esden/fx2grok/hardware/fx2grok-flat/0.3/fx2grok-flat.kicad_pcb

## KiCad design hardware/fx2grok-flat/0.3/fx2grok-flat.kicad_pcb (2018-04-19)

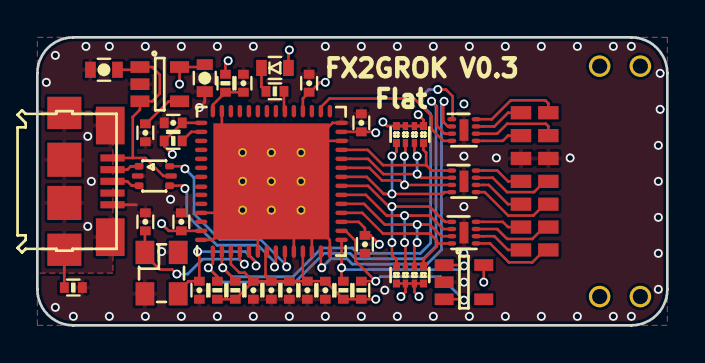
[picture p1: board hardware/fx2grok-flat/0.3/fx2grok-flat.kicad_pcb from above]

Board: 4 copper layers, 35.0 x 16.0 mm, 37 parts (0 on the bottom side), 41 nets.

Parts:
C1, C2, C3, C4, C5, C6, C9, C10: 100n; C_0402
C7, C8: 2u2; C_0402
C11, C13: 4u7; C_0603
C12: 10n; C_0402
C14: 1u; C_0402
C15, C16: 10p; C_0402
D1: GRN; D_0603
IC1: CY7C68013A-56; QFN-56-1EP_8x8mm_Pitch0.5mm
J1: Conn; TFM-107-02-x-DH
P1: pkl_USB_OTG; Connector_USB_Micro_B_SMD
R1, R2, R3, R4: 2k7; R_0402
R5, R6, R7: 100k; R_0402
R8, R9: 100k; R_Array_Convex_4x0402
R10: 1m; R_0402
U1: 3.3V; SOT-23-5
U2: USBLC6-2; SOT-666
U3, U4, U6: IP425x-4-TTL; DFN-8-1EP_1.35x1.7mm_Pitch0.4mm
U5: 24LC00; SOT-23-5
X1: 24MHz; ABM8

Connections:
+3V3: C1.1, C2.1, C3.1, C4.1, C5.1, C6.1, C7.1, C8.1, C9.1, C10.1, C13.1, D1.A, IC1.3, IC1.7, IC1.11, IC1.17, IC1.27, IC1.32, IC1.43, IC1.55, R2.2, R3.2, R4.2, R5.2, R6.1, R7.1, R8.2, R8.4, R8.6, R8.8, R9.2, R9.4, R9.6, R9.8, U1.5, U5.5
+5V: C11.1, P1.1, U1.1, U1.3, U2.5
/CLK: IC1.30, U6.4
/IFCLK: IC1.13, U6.2
/PA1: IC1.34, R1.2
/PB0: IC1.18, R8.1, U3.4
/PB1: IC1.19, R8.3, U3.3
/PB2: IC1.20, R8.5, U3.2
/PB3: IC1.21, R8.7, U3.1
/PB4: IC1.22, R9.1, U4.4
/PB5: IC1.23, R9.3, U4.3
/PB6: IC1.24, R9.5, U4.2
/PB7: IC1.25, R9.7, U4.1
/SCL: IC1.15, R2.1, U5.1
/SDA: IC1.16, R3.1, U5.3
/TRIG: IC1.1, R6.2, U6.3
/TRIG2: IC1.2, R7.2, U6.1
/USBD_N: IC1.9, U2.6
/USBD_P: IC1.8, U2.4
/WAKEUP: IC1.44, R5.1
/XTALIN: C16.1, IC1.5, X1.2
/XTALOUT: C15.1, IC1.4, X1.1
/shield: P1.GND, R10.1
/xCLK: J1.12, U6.5
/xIFCLK: J1.14, U6.7
/xPB0: J1.1, U3.5
/xPB1: J1.2, U3.6
/xPB2: J1.3, U3.7
/xPB3: J1.4, U3.8
/xPB4: J1.5, U4.5
/xPB5: J1.6, U4.6
/xPB6: J1.7, U4.7
/xPB7: J1.8, U4.8
/xTRIG: J1.11, U6.6
/xTRIG2: J1.13, U6.8
/xUSBD_N: P1.2, U2.1
/xUSBD_P: P1.3, U2.3
/~RESET: C14.1, IC1.42, R4.1
GND: C1.2, C2.2, C3.2, C4.2, C5.2, C6.2, C7.2, C8.2, C9.2, C10.2, C11.2, C12.2, C13.2, C14.2, C15.2, C16.2, IC1.6, IC1.10, IC1.12, IC1.14, IC1.26, IC1.28, IC1.41, IC1.53, IC1.56, IC1.57, J1.9, J1.10, P1.5, R10.2, U1.2, U2.2, U3.9, U4.9, U5.2, U6.9, X1.GND
unnamed: C12.1, U1.4
unnamed: D1.C, R1.1
