esden/fx2grok/hardware/fx2grok-flat/0.1/fx2grok-flat.kicad_pcb

## KiCad design hardware/fx2grok-flat/0.1/fx2grok-flat.kicad_pcb (2018-04-13, an earlier design)

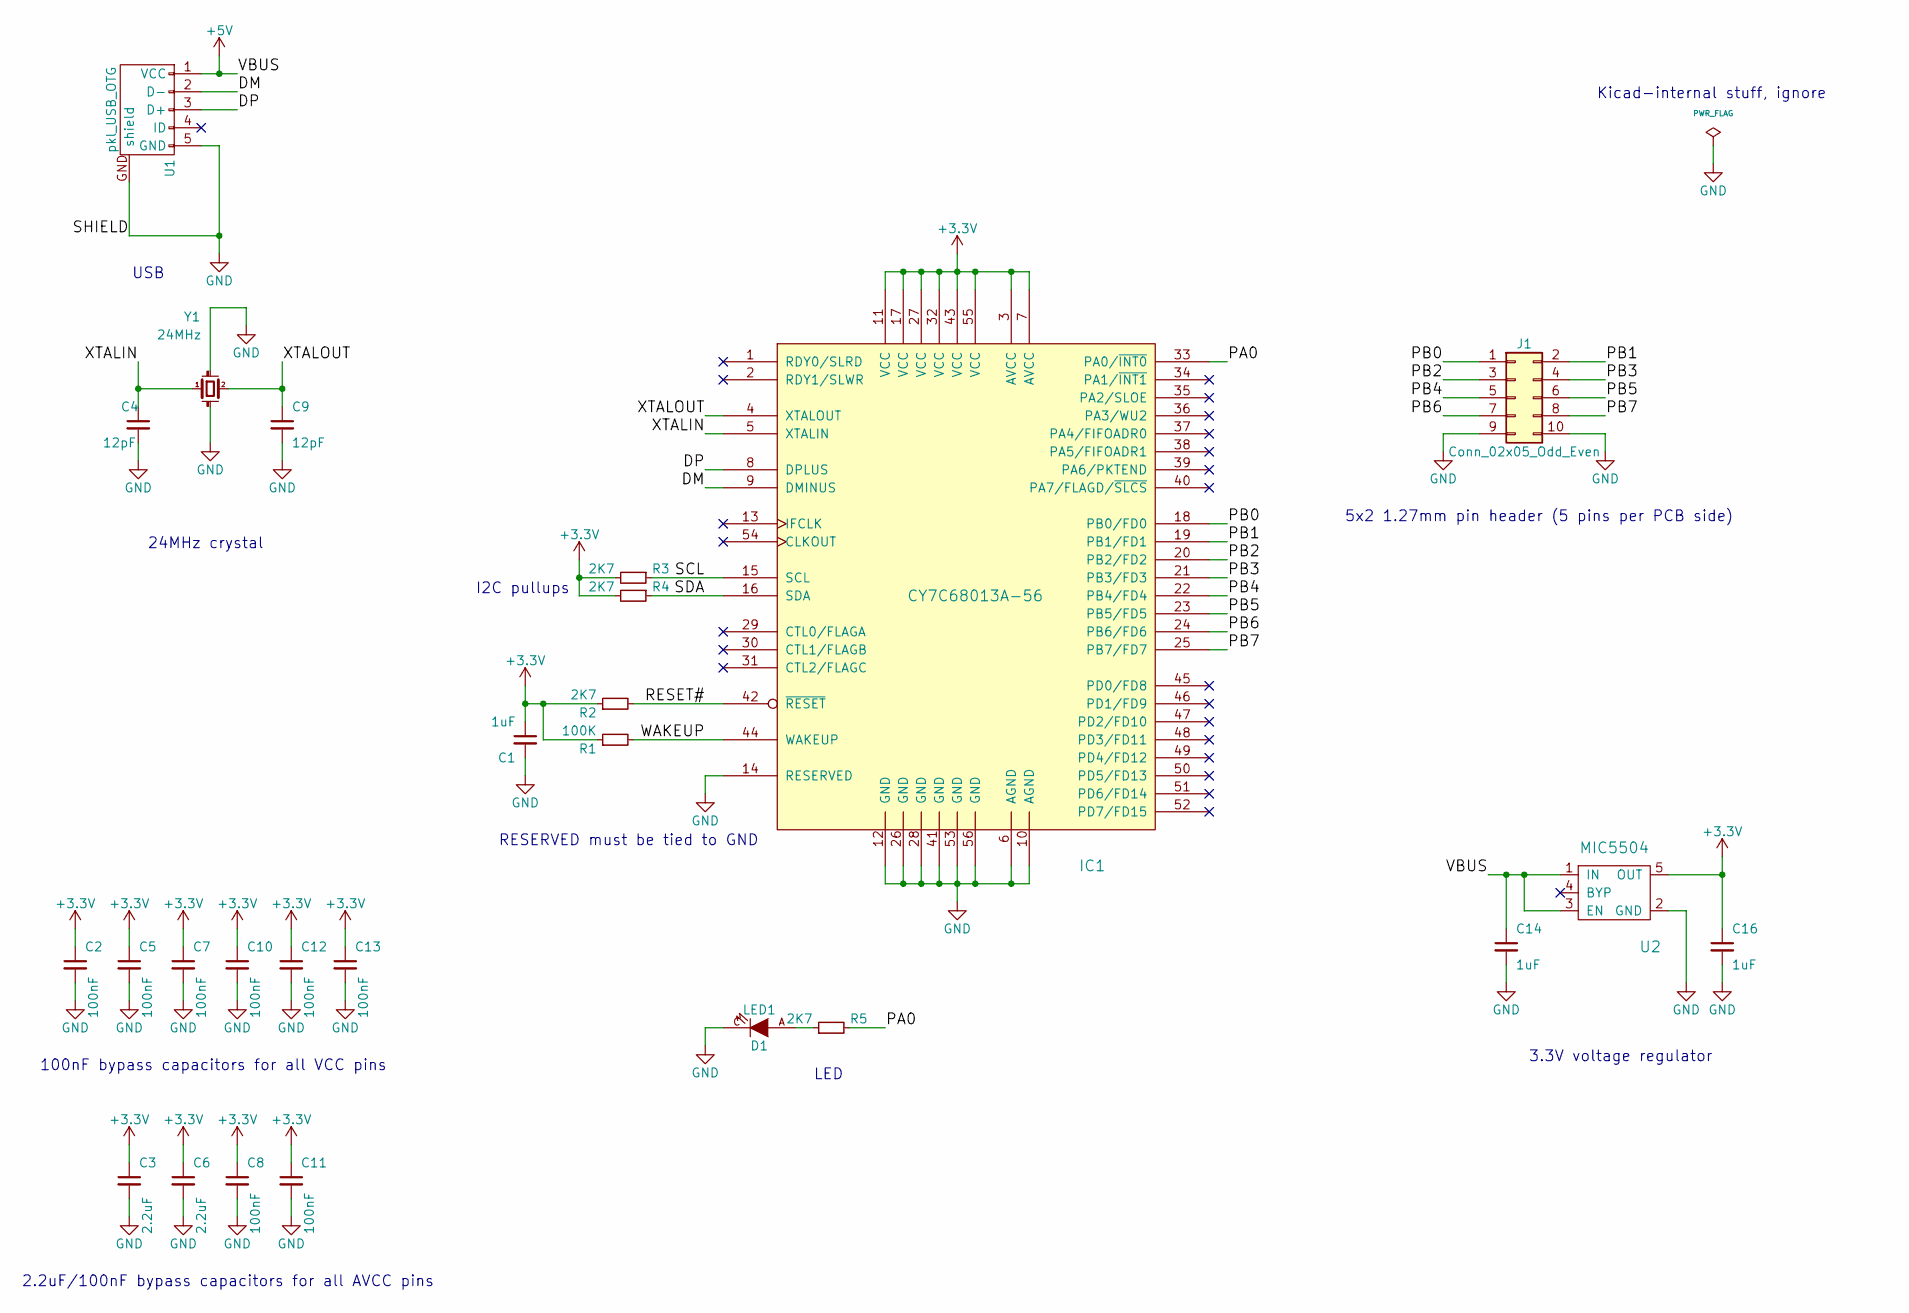
[picture p2: schematic fx2grok-flat.sch]

Parts:
C1, C14, C16: 1uF; C_0402
C2, C5, C7, C8, C10, C11, C12, C13: 100nF; C_0402
C3, C6: 2.2uF; C_0402
C4, C9: 12pF; C_0402
D1: LED1; D_0603
IC1: CY7C68013A-56; QFN-56-1EP_8x8mm_Pitch0.5mm
J1: Conn_02x05_Odd_Even; FTSH-105-XX-X-DV
R1: 100K; R_0402
R2, R3, R4, R5: 2K7; R_0402
U1: pkl_USB_OTG; Connector_USB_Micro_B_SMD
U2: MIC5504; SOT-23-5
Y1: 24MHz; ABM8

Connections:
+3V3: C1.1, C2.1, C3.1, C5.1, C6.1, C7.1, C8.1, C10.1, C11.1, C12.1, C13.1, C16.1, IC1.3 (AVCC), IC1.7 (AVCC), IC1.11 (VCC), IC1.17 (VCC), IC1.27 (VCC), IC1.32 (VCC), IC1.43 (VCC), IC1.55 (VCC), R1.1, R2.1, R3.2, R4.2, U2.5 (OUT)
+5V: C14.1, U1.1 (VCC), U2.1 (IN), U2.3 (EN)
/DM: IC1.9 (DMINUS), U1.2 (D-)
/DP: IC1.8 (DPLUS), U1.3 (D+)
/PA0: IC1.33 (PA0/~INT0), R5.2
/PB0: IC1.18 (PB0/FD0), J1.1
/PB1: IC1.19 (PB1/FD1), J1.2
/PB2: IC1.20 (PB2/FD2), J1.3
/PB3: IC1.21 (PB3/FD3), J1.4
/PB4: IC1.22 (PB4/FD4), J1.5
/PB5: IC1.23 (PB5/FD5), J1.6
/PB6: IC1.24 (PB6/FD6), J1.7
/PB7: IC1.25 (PB7/FD7), J1.8
/RESET#: IC1.42 (~RESET), R2.2
/SCL: IC1.15 (SCL), R3.1
/SDA: IC1.16 (SDA), R4.1
/WAKEUP: IC1.44 (WAKEUP), R1.2
/XTALIN: C4.1, IC1.5 (XTALIN), Y1.1
/XTALOUT: C9.1, IC1.4 (XTALOUT), Y1.2
GND: C1.2, C2.2, C3.2, C4.2, C5.2, C6.2, C7.2, C8.2, C9.2, C10.2, C11.2, C12.2, C13.2, C14.2, C16.2, D1.C, IC1.6 (AGND), IC1.10 (AGND), IC1.12 (GND), IC1.14 (RESERVED), IC1.26 (GND), IC1.28 (GND), IC1.41 (GND), IC1.53 (GND), IC1.56 (GND), J1.9, J1.10, U1.5 (GND), U1.GND (shield), U2.2 (GND), Y1.GND (case)
unnamed: D1.A, R5.1

Notes on the sheet:
5x2 1.27mm pin header (5 pins per PCB side)
Kicad-internal stuff, ignore
LED
24MHz crystal
3.3V voltage regulator
USB
RESERVED must be tied to GND
2.2uF/100nF bypass capacitors for all AVCC pins
100nF bypass capacitors for all VCC pins
I2C pullups

Board: 4 copper layers, 26 parts (0 on the bottom side), 21 nets, no tracks yet.
