esden/fx2grok/(commit log)

2017-09-23 fx2grok-tiny: Move all files into 0.1/ again after all.
    [fx2grok-tiny-B.Cu.gbl, fx2grok-tiny-B.Mask.gbs, fx2grok-tiny-B.Paste.gbp, fx2grok-tiny-Edge.Cuts.gm1, fx2grok-tiny-F.Cu.gtl, fx2grok-tiny-F.Mask.gts, fx2grok-tiny-F.Paste.gtp, fx2grok-tiny-drl_map.gbr]
2017-09-23 fx2grok-tiny: Add missing Y1 to silkscreen.
    [fx2grok-tiny.kicad_pcb]
2017-09-23 fx2grok-tiny: Add a silkscreen circle for the FX2's pin 1.
    [fx2grok-tiny.kicad_pcb]
2017-09-23 fx2grok-tiny: Place "values" on silkscreen but hide by default.
    These can be enabled when needed to have a nice assembly helper
    view in the Kicad 3D viewer.
    [fx2grok-tiny.kicad_pcb]
2017-09-23 fx2grok-tiny: Add warnings that version 0.1 is broken.
    [fx2grok-tiny.kicad_pcb, fx2grok-tiny.sch]
2017-09-29 fx2grok-tiny: Add initial 0.2 version.
    Almost identical to 0.1, only the metadata has been updated
    and the 0.1 being broken warnings are removed.
    [fx2grok-tiny.kicad_pcb, fx2grok-tiny.sch]
2017-09-29 fx2grok-tiny: Fix incorrect FX2 footprint.
    [fx2grok-tiny.kicad_pcb]
2017-09-29 fx2grok-tiny: Reroute PCB from scratch with various changes.
    - The previously incorrect FX2 footprint is fixed now.
    - The FX2's thermal pad is set to GND now.
    - The FX2 footprint now has a dot on the copper as well as on the
    silkscreen for pin 1.
    - The PCB is now 11x11mm (instead of 13x13mm).
    - The 1.27mm pin header connectors are shortened and the pinout changed.
    - The trace clearance changed from 6mil to 5mil.
    - The USB connector footprint now has two oval pads (space reasons).
    - The LED is now connected to PA1 (not PA0).
    - The schematics/layout license is changed to CC-BY-SA 4.0.
    [fx2grok-tiny.kicad_pcb, fx2grok-tiny.sch]
2017-09-29 fx2grok-tiny: Add generated 0.2 Gerber files.
    [fx2grok-tiny-B.Cu.gbl, fx2grok-tiny-B.Mask.gbs, fx2grok-tiny-B.Paste.gbp, fx2grok-tiny-Edge.Cuts.gm1, fx2grok-tiny-F.Cu.gtl, fx2grok-tiny-F.Mask.gts, fx2grok-tiny-F.Paste.gtp, fx2grok-tiny.drl]
2017-12-16 fx2grok-tiny: Random cosmetic/silkscreen changes.
    These are mostly done for being able to generate nice 3D previews in
    KiCad that can be helpful for assembling the device.
    [fx2grok-tiny.kicad_pcb]
2018-04-13 Added gitignore for kicad backup and net files.
2018-04-13 Added pretty-kicad-libs library submodule.
2018-04-13 Initial commit of fx2grok-flat.
    [fx2grok-flat.kicad_pcb, fx2grok-flat.sch]
2018-04-13 Recreated original schematic + input protection.
    [fx2grok-flat.kicad_pcb, fx2grok-flat.sch]
2018-04-13 Added eeprom and pullups on probe inputs. Started routing.
    [fx2grok-flat.kicad_pcb, fx2grok-flat.sch]
2018-04-13 FX2Grok-flat with new frontend first routing pass.
    This is the status of the design as included on esden KiCad LP.
    [fx2grok-flat.kicad_pcb, fx2grok-flat.sch]
2018-04-13 Cleaned up and grouped schematic sections.
    [fx2grok-flat.sch]
2018-04-13 More cleanup of the board routing.
    [fx2grok-flat.kicad_pcb, fx2grok-flat.sch]
2018-04-13 Final cleanup before placing prototype order.
    [fx2grok-flat.kicad_pcb]
2018-04-13 Placement plan layout.
    [fx2grok-flat.kicad_pcb]
2018-04-13 Added BOM unique part keys and made a few minor adjustments.
    [fx2grok-flat.sch]
2018-04-13 Minor value adjustment.
    [fx2grok-flat.kicad_pcb, fx2grok-flat.sch]
2018-04-14 Initial commit of fx2grok-flat V0.3.
    [fx2grok-flat.kicad_pcb, fx2grok-flat.sch]
2018-04-14 Added 3d models to the board file.
    [fx2grok-flat.kicad_pcb]
2018-04-19 Moved config flash to clean up PB0 trace.
    [fx2grok-flat.kicad_pcb]
2018-04-19 Untangled the TRIG and IFCLK traces.
    [fx2grok-flat.kicad_pcb]
2018-04-19 Added TRIG2 (RDY1/SLWR) as per @StefanBruens request. :D
    [fx2grok-flat.kicad_pcb, fx2grok-flat.sch]
2018-04-19 Added via stitching around the board.
    [fx2grok-flat.kicad_pcb]
2018-04-19 Corrected board length. (was off by 0.1mm)
    [fx2grok-flat.kicad_pcb]
2018-04-19 Updated USB ESD diode network chip footprint.
    [fx2grok-flat.kicad_pcb]
2018-04-19 Added TRIG2 silkscreen designator.
    [fx2grok-flat.kicad_pcb]
2018-04-19 Added GND via and fixed a DRC error.
    [fx2grok-flat.kicad_pcb]
2018-04-19 Left a note that the next revision has to get roundrect pads.
    Totally forgot to change them... and I already ordered the boards so it
    is too late for the current revision. :(
    [fx2grok-flat.kicad_pcb]
