esden/fx2grok/(notices)

Notices in the files:
hardware/fx2grok-flat/0.1/fx2grok-flat.sch:
CC-BY-SA V4.0
hardware/fx2grok-tiny/0.2/fx2grok-tiny.sch:
Open Hardware, CC-BY-SA 4.0
hardware/fx2grok-flat/0.2/fx2grok-flat.kicad_pcb:
(C) 2017 1BitSquared
(C) 2017 Piotr Esden-Tempski
hardware/fx2grok-tiny/0.1/fx2grok-tiny.sch:
Open Hardware, CC-BY-SA 3.0
